sorenmik/sbig_cfw8_to_indi_bridge/docs/v1_nano.jpg

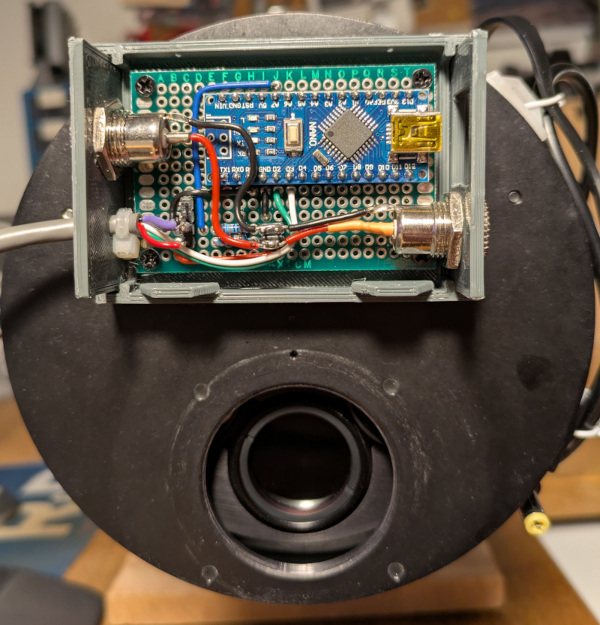
docs/v1_nano.jpg
