sorenmik/sbig_cfw8_to_indi_bridge/docs/v2_samd21_b.jpg

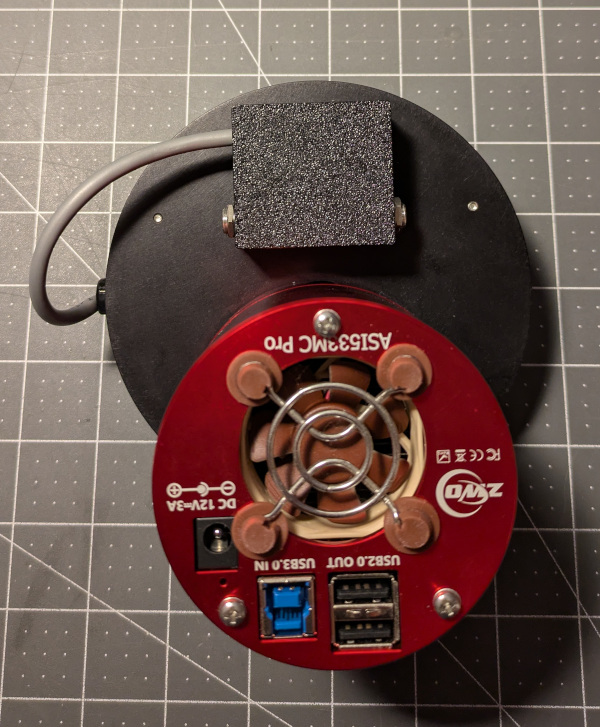
docs/v2_samd21_b.jpg
