sorenmik/sbig_cfw8_to_indi_bridge/(commit log)

2026-01-22 GND spec
2026-02-03 Found wheel with black ground wire
2026-02-03 Add TODO for user to use own arduino-cli path
2026-02-07 Rm purple as gnd wire colour
